LonghornRacingElectric/HVPCB_2023/README.md

# 2023 HVPCB

<p>
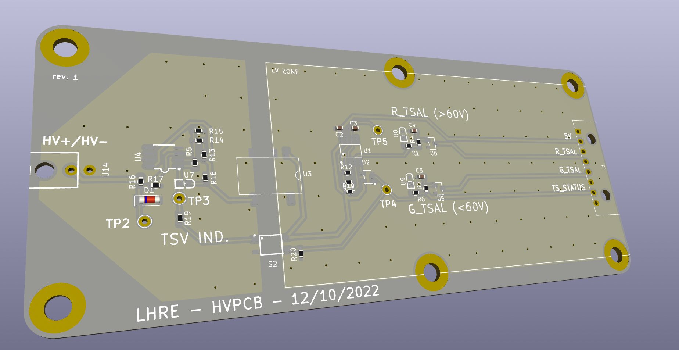
[picture p1: HVPCB/HVPCB_IMAGE.png]
    
</p>

### HVPCB Board

#### 2023 Longhorn Racing Electric

UPDATED: 12/12/2022 - Robert Kirk
