LonghornRacingElectric/HVPCB_2023/ResistorNetwork/ResistorNetwork.kicad_pcb

## KiCad design ResistorNetwork/ResistorNetwork.kicad_pcb (2023-01-10)

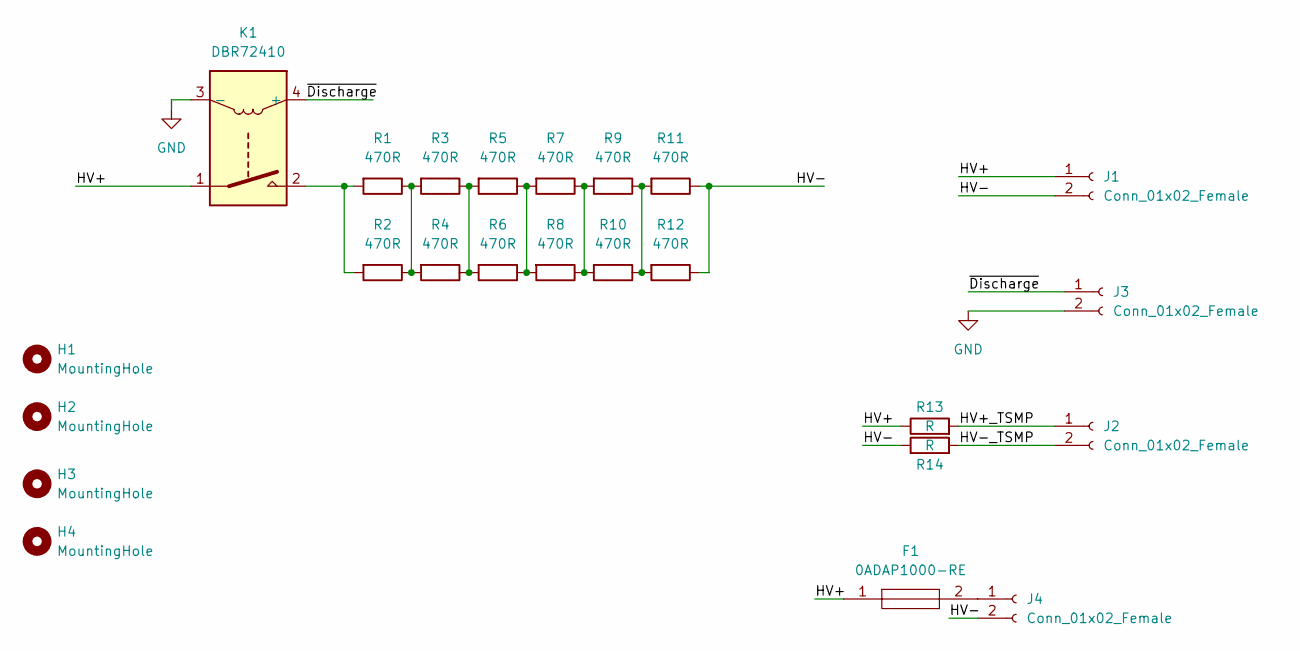
[picture p2: schematic ResistorNetwork.kicad_sch]

Parts:
F1: 0ADAP1000-RE; 0ADAP1000RE; Manufacturer_Part_Number 0ADAP1000-RE; Mouser Part Number 530-0ADAP1000-RE
H1, H2, H3, H4: MountingHole; MountingHole_4.3mm_M4
J1, J2, J3, J4: Conn_01x02_Female; Molex_Micro-Fit_3.0_43045-0200_2x01_P3.00mm_Horizontal
K1: DBR72410; DBT70510U
R1, R2, R3, R4, R5, R6, R7, R8, R9, R10, R11, R12: 470R; TO-263-2_TabPin1; Part # PWR263S-35-2500JE
R13, R14: R; 3550 Resistor TE

Connections:
/HV+: F1.1, J1.1, K1.1, R13.1
/HV+_TSMP: J2.1, R13.2
/HV-: J1.2, J4.2, R11.1, R12.1, R14.1
/HV-_TSMP: J2.2, R14.2
/~Discharge: J3.1, K1.4 (+)
GND: J3.2, K1.3 (-)
unnamed: F1.2, J4.1
unnamed: R1.1, R2.1, R3.2, R4.2
unnamed: K1.2, R1.2, R2.2
unnamed: R3.1, R4.1, R5.2, R6.2
unnamed: R5.1, R6.1, R7.2, R8.2
unnamed: R9.1, R10.1, R11.2, R12.2
unnamed: R7.1, R8.1, R9.2, R10.2

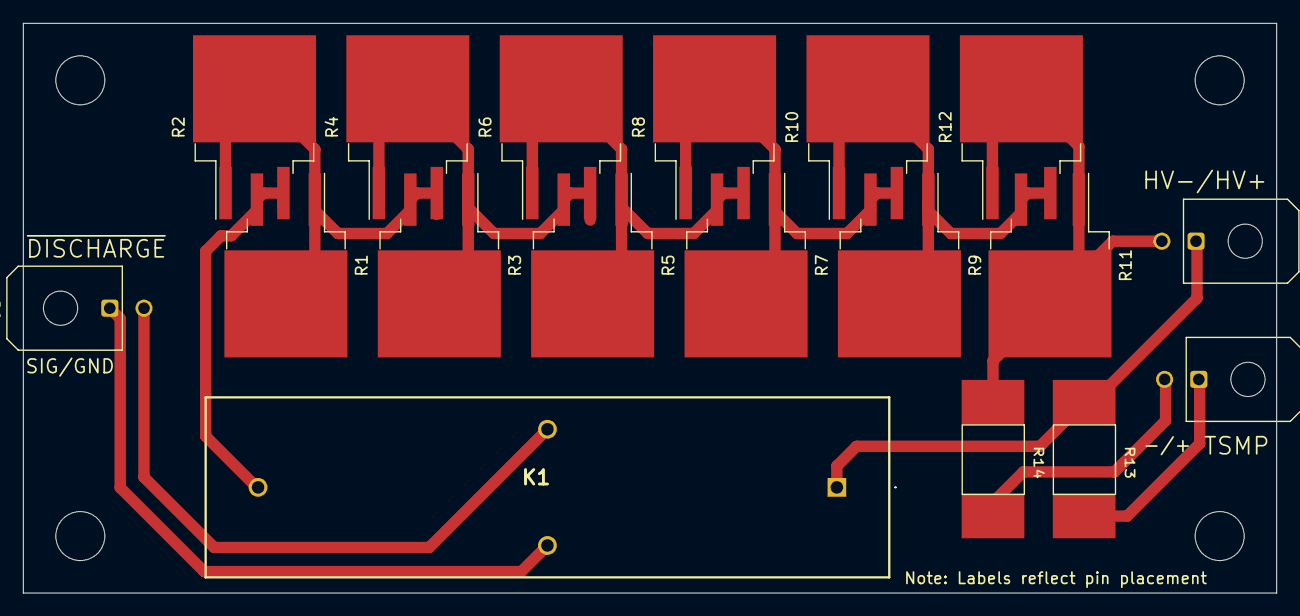
[picture p3: board ResistorNetwork.kicad_pcb from above]

Board: 2 copper layers, 110.0 x 50.0 mm, 22 parts (0 on the bottom side), 12 nets.
