LonghornRacingElectric/HVPCB_2023/HVPCB/HVPCB.kicad_pcb

## KiCad design HVPCB/HVPCB.kicad_pcb (2022-12-17)

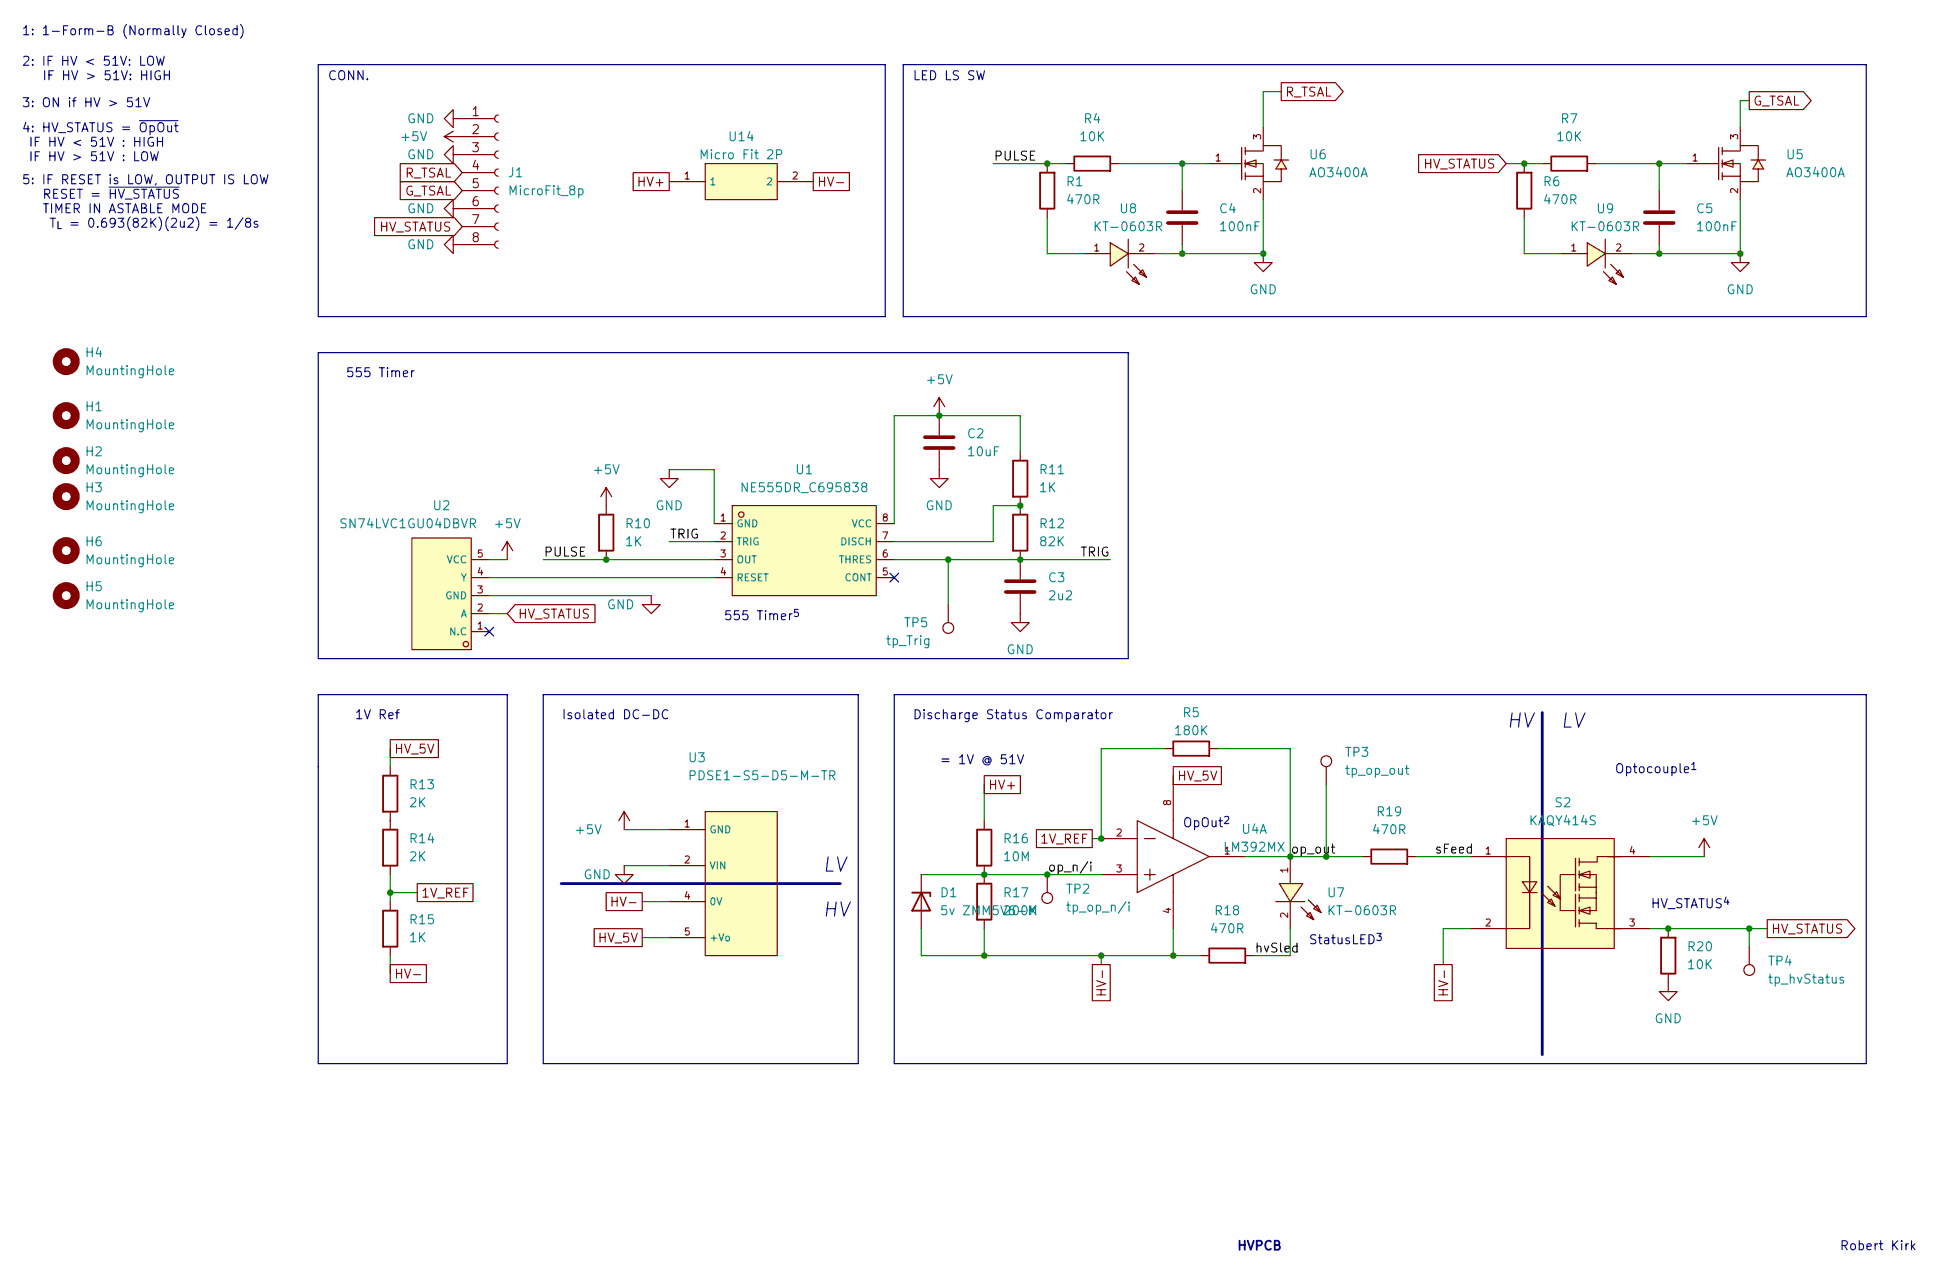
[picture p4: schematic HVPCB.kicad_sch]

Parts:
C2: 10uF; C_0603_1608Metric_Pad1.08x0.95mm_HandSolder
C3: 2u2; C_0603_1608Metric_Pad1.08x0.95mm_HandSolder
C4, C5: 100nF; C_0603_1608Metric_Pad1.08x0.95mm_HandSolder
D1: 5v ZMM5V6-M; D_MiniMELF
H1, H2, H3, H4, H5, H6: MountingHole; MountingHole_2.2mm_M2
J1: MicroFit_8p; Molex_Micro-Fit_3.0_43650-0800_1x08_P3.00mm_Horizontal
R1, R6, R18, R19: 470R; R_0603_1608Metric_Pad0.98x0.95mm_HandSolder
R4, R7, R20: 10K; R_0603_1608Metric_Pad0.98x0.95mm_HandSolder
R5: 180K; R_0603_1608Metric_Pad0.98x0.95mm_HandSolder
R10, R11, R15: 1K; R_0603_1608Metric_Pad0.98x0.95mm_HandSolder
R12: 82K; R_0603_1608Metric_Pad0.98x0.95mm_HandSolder
R13, R14: 2K; R_0603_1608Metric_Pad0.98x0.95mm_HandSolder
R16: 10M; R_0603_1608Metric_Pad0.98x0.95mm_HandSolder
R17: 200K; R_0603_1608Metric_Pad0.98x0.95mm_HandSolder
S2: KAQY414S; SOP-4_L3.9-W4.4-P2.54-LS7.0-BR; LCSC C2890346
TP2: tp_op_n/i; TestPoint_THTPad_D2.0mm_Drill1.0mm
TP3: tp_op_out; TestPoint_THTPad_D2.0mm_Drill1.0mm
TP4: tp_hvStatus; TestPoint_THTPad_D2.0mm_Drill1.0mm
TP5: tp_Trig; TestPoint_THTPad_D2.0mm_Drill1.0mm
U1: NE555DR_C695838; SOP-8_L5.0-W4.0-P1.27-LS6.0-BL; LCSC C695838
U2: SN74LVC1GU04DBVR; SOT-23-5_L3.0-W1.7-P0.95-LS2.8-BR; LCSC C81934
U3: PDSE1-S5-D5-M-TR; CUI Isolated DC-DC; LCSC Mouser
U4: LM392MX; SOIC-8_L5.0-W4.0-P1.27-LS6.0-BL; LCSC C7954
U5, U6: AO3400A; SOT-23-3_L2.9-W1.6-P1.90-LS2.8-BR; LCSC C20917
U7, U8, U9: KT-0603R; LED0603-R-RD; LCSC C2286
U14: Micro Fit 2P; CONN-TH_43045-0200; LCSC C122431

Connections:
1V_REF: R5.1, R14.2, R15.1, U4.2 (INA-)
+5V: C2.1, J1.2, R10.1, R11.1, S2.4, U1.8 (VCC), U2.5 (VCC), U3.1 (GND)
/PULSE: R1.2, R4.1, R10.2, U1.3 (OUT)
/TRIG: C3.1, R12.2, TP5.1, U1.2 (TRIG), U1.6 (THRES)
/hvSled: R18.2, U7.2 (K)
/op_n/i: D1.1 (K), R16.2, R17.1, TP2.1, U4.3 (INA+)
/op_out: R5.2, R19.1, TP3.1, U4.1 (OUTA), U7.1 (A)
/sFeed: R19.2, S2.1
GND: C2.2, C3.2, C4.2, C5.2, J1.1, J1.3, J1.6, J1.8, R20.1, U1.1 (GND), U2.3 (GND), U3.2 (VIN), U5.2 (S), U6.2 (S), U8.2 (K), U9.2 (K)
G_TSAL: J1.5, U5.3 (D)
HV+: R16.1, U14.1
HV-: D1.2 (A), R15.2, R17.2, R18.1, S2.2, U3.4 (0V), U4.4 (GND), U14.2
HV_5V: R13.1, U3.5 (+Vo), U4.8 (V+)
HV_STATUS: J1.7, R6.2, R7.1, R20.2, S2.3, TP4.1, U2.2 (A)
unnamed: C4.1, R4.2, U6.1 (G)
unnamed: C5.1, R7.2, U5.1 (G)
unnamed: R1.1, U8.1 (A)
unnamed: R6.1, U9.1 (A)
unnamed: R11.2, R12.1, U1.7 (DISCH)
unnamed: R13.2, R14.1
unnamed: U1.4 (RESET), U2.4 (Y)
R_TSAL: J1.4, U6.3 (D)

Notes on the sheet:
555 Timer
HV_STATUS^{4}
Optocouple^{1}
= 1V @ 51V
1V Ref
CONN.
Discharge Status Comparator
555 Timer^{5}
OpOut^{2}
Robert Kirk
HVPCB
Isolated DC-DC
5: IF RESET is LOW, OUTPUT IS LOW RESET = ~{HV_STATUS} TIMER IN ASTABLE MODE T_{L} = 0.693(82K)(2u2) = 1/8s
LED LS SW
StatusLED^{3}
3: ON if HV > 51V
2: IF HV < 51V: LOW IF HV > 51V: HIGH
1: 1-Form-B (Normally Closed)
4: HV_STATUS = ~{OpOut} IF HV < 51V : HIGH IF HV > 51V : LOW

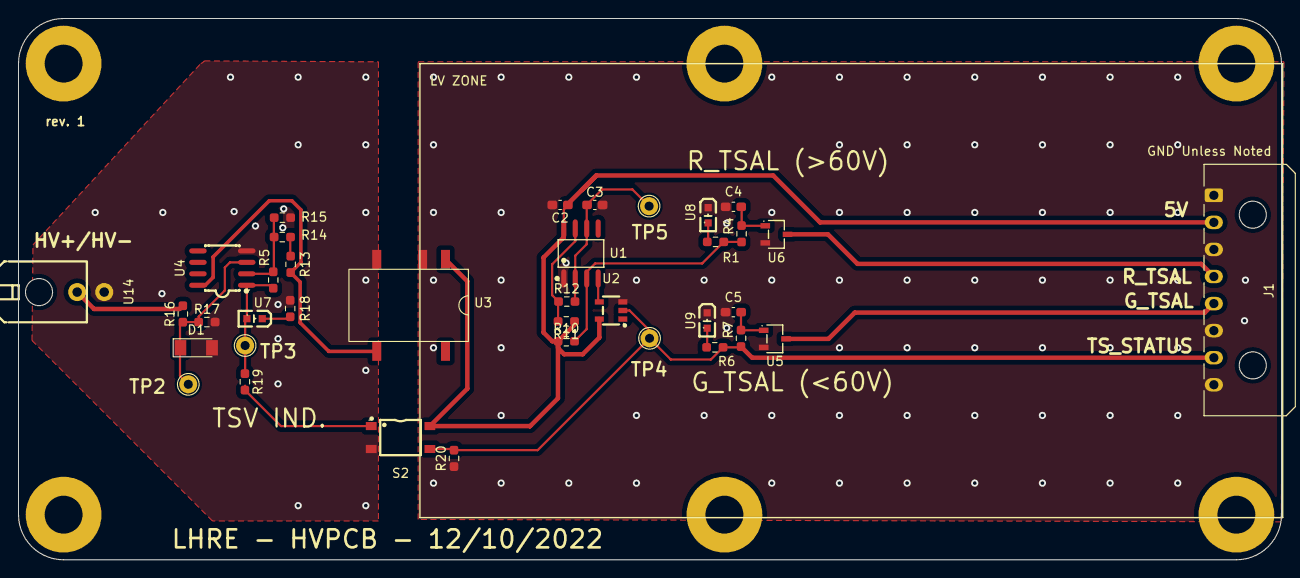
[picture p5: board HVPCB.kicad_pcb from above]

Board: 2 copper layers, 140.0 x 60.0 mm, 43 parts (0 on the bottom side), 22 nets.
