LonghornRacingElectric/HVPCB_2023/(commit log)

2022-11-06 Initial commit to add schematic files for HVPCB & ResNetwork. Pending approval...
    [HVPCB.kicad_pcb, HVPCB.kicad_sch, ResistorNetwork.kicad_pcb, ResistorNetwork.kicad_sch]
2022-11-13 updated board drawing to add mounting holes, updated test points and moved components to general proximity
    [HVPCB.kicad_pcb, HVPCB.kicad_sch]
2022-11-18 added mounting holes and organized board
    [HVPCB.kicad_pcb, HVPCB.kicad_sch]
2022-11-27 progress on layout
    [HVPCB.kicad_pcb]
2022-11-27 routing of 555 timer
    [HVPCB.kicad_pcb]
2022-11-27 layout almost done
    [HVPCB.kicad_pcb, HVPCB.kicad_sch]
2022-11-27 finished layout
    [HVPCB.kicad_pcb, HVPCB.kicad_sch]
2022-11-27 resistor network layout done
    [ResistorNetwork.kicad_pcb, ResistorNetwork.kicad_sch]
2022-11-27 adjusted resistor values to match thermal requirements
    [ResistorNetwork.kicad_sch]
2022-12-11 switch to tht molex 1x10
    [HVPCB.kicad_sch]
2022-12-12 added new relay and TSMP resistors
    [ResistorNetwork.kicad_pcb, ResistorNetwork.kicad_sch]
2022-12-12 added gerbers
    [ResistorNetwork-B_Cu.gbr, ResistorNetwork-B_Mask.gbr, ResistorNetwork-B_Paste.gbr, ResistorNetwork-B_Silkscreen.gbr, ResistorNetwork-Edge_Cuts.gbr, ResistorNetwork-F_Cu.gbr, ResistorNetwork-F_Mask.gbr, ResistorNetwork-F_Paste.gbr]
2022-12-12 added BOM
    [ResistorNetwork-B_Cu.gbr, ResistorNetwork-B_Mask.gbr, ResistorNetwork-B_Paste.gbr, ResistorNetwork-B_Silkscreen.gbr, ResistorNetwork-Edge_Cuts.gbr, ResistorNetwork-F_Cu.gbr, ResistorNetwork-F_Mask.gbr, ResistorNetwork-F_Paste.gbr]
2022-12-12 final changes
    [ResistorNetwork.kicad_pcb]
2022-12-12 HVPCB updates & assembly files
    [HVPCB-B_Cu.gbr, HVPCB-B_Mask.gbr, HVPCB-B_Paste.gbr, HVPCB-B_Silkscreen.gbr, HVPCB-Edge_Cuts.gbr, HVPCB-F_Cu.gbr, HVPCB-F_Mask.gbr, HVPCB-F_Paste.gbr]
2022-12-12 added value for TSMP resistor
    [ResistorNetwork.xlsx, ResistorNetworkBOM.xlsx]
2022-12-12 removed csv from gitignore oops, BOMS should appear now
    [HVPCB_BOM.csv, ResistorNetworkBOM.csv]
2022-12-17 updates to silkscreen for HVPCB
    [HVPCB.kicad_pcb]
2022-12-17 updates to silkscreen for resistor network
    [ResistorNetwork.kicad_pcb]
2022-12-17 updated gerbers and BOMs
    [HVPCB_BOM.csv, HVPCB_BOM.xlsx, HVPCB_BOM_MOUSER.csv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]
2022-12-26 added contactor fuse
    [ResistorNetwork.kicad_pcb, ResistorNetwork.kicad_sch]
2023-01-10 fixed routing error oops
    [ResistorNetwork.kicad_pcb]
